GoTouchGra55/CASSINI/Assets/Daraz1.jpg

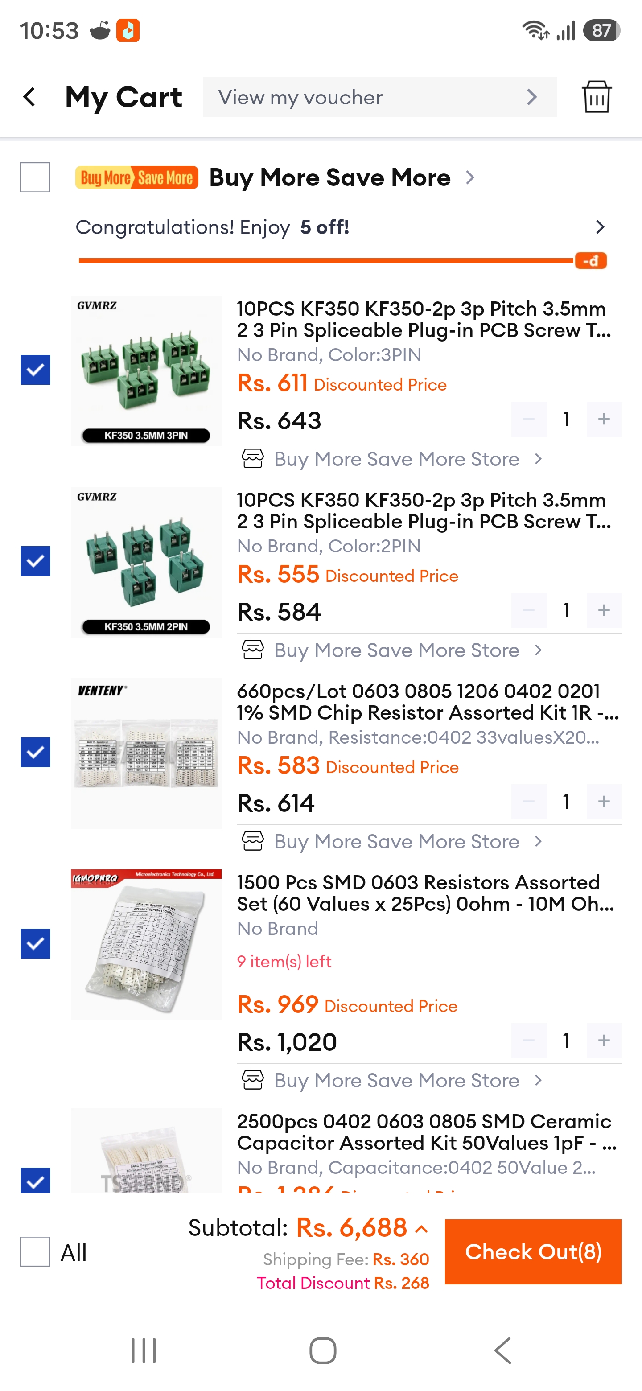
Assets/Daraz1.jpg
