GoTouchGra55/CASSINI/Assets/Daraz2.jpg

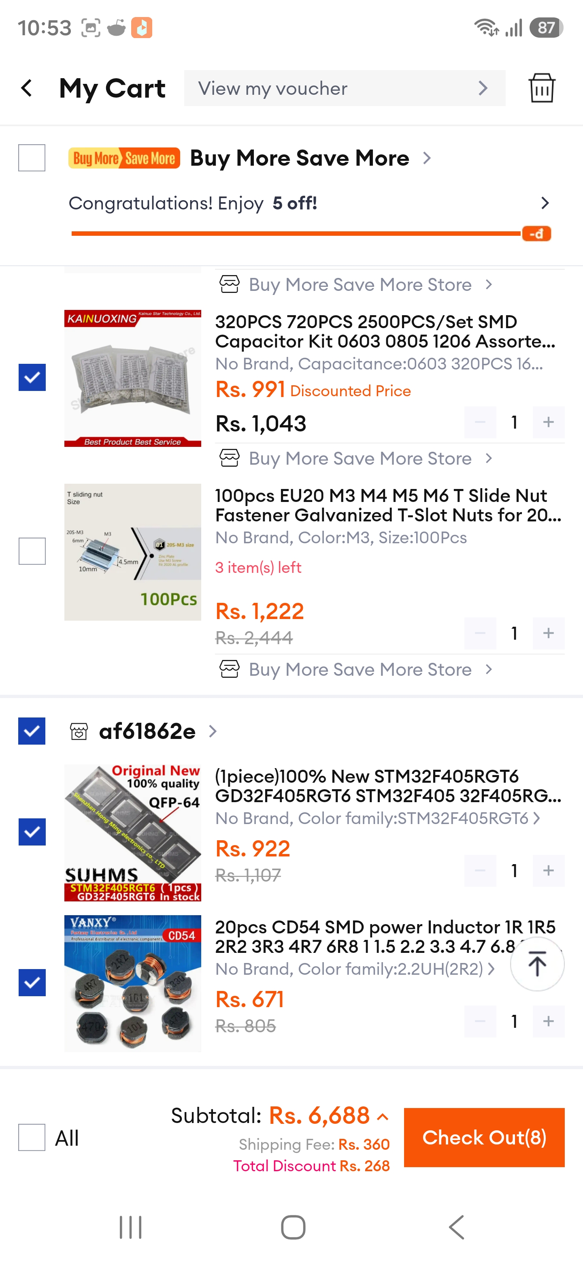
Assets/Daraz2.jpg
