GoTouchGra55/CASSINI/Assets/Daraz3.jpg

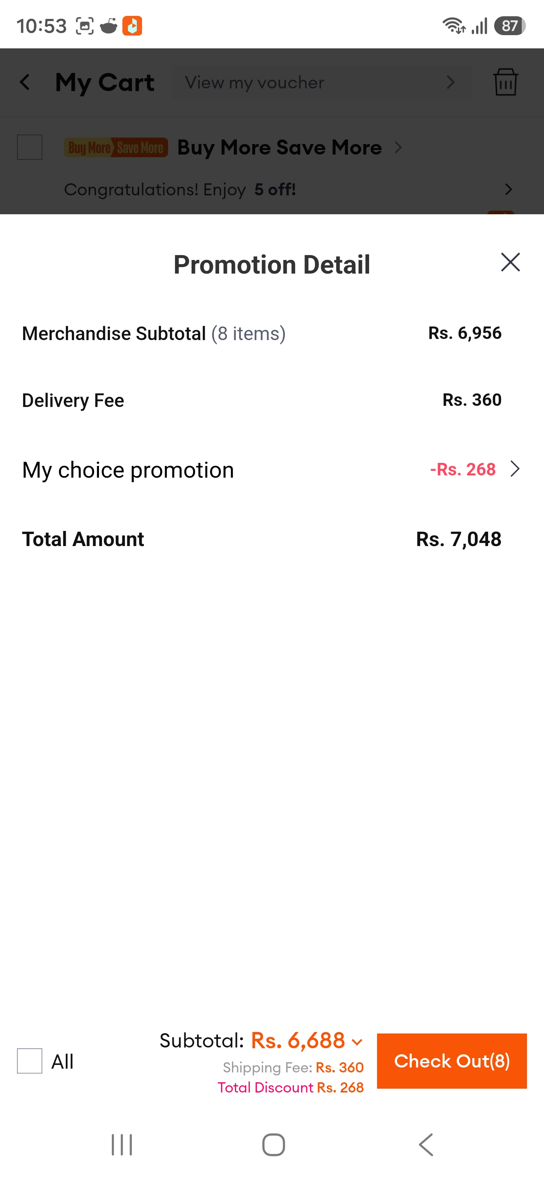
Assets/Daraz3.jpg
