GoTouchGra55/CASSINI/Assets/JLC.png

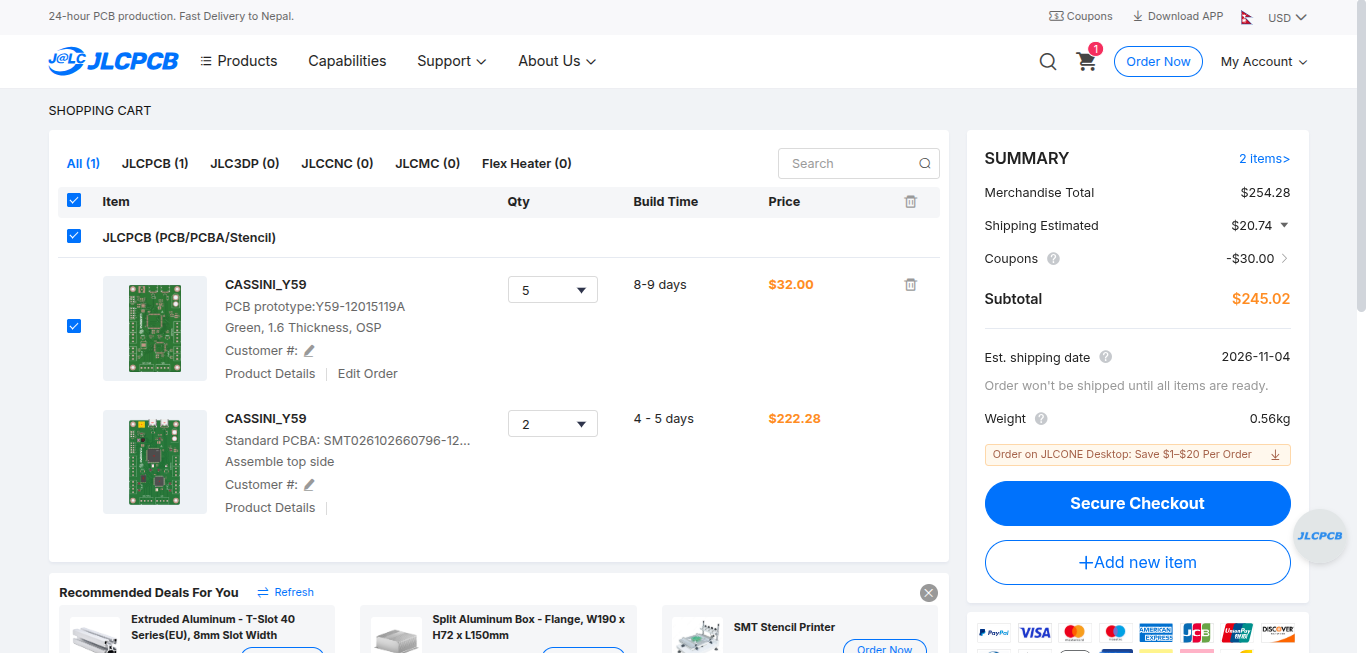
Assets/JLC.png
