GoTouchGra55/CASSINI/BOM.csv

# | Component / Item | Specifications | Qty. | Price (USD)
1 | KF350 Terminal Blocks | 3-pin | 3.5 mm pitch | 10 pcs/lot | 1 lot | $4.03
2 | KF350 Terminal Blocks | 2-pin | 3.5 mm pitch | 10 pcs/lot | 1 lot | $3.67
3 | SMD Resistor Assortment | 660 pcs | mixed packages and values | 1 kit | $3.85
4 | SMD Resistor Assortment | 1 | 500 pcs | 0603 | 60 values | 1 kit | $6.40
5 | SMD Ceramic Capacitor Assortment | 2 | 500 pcs | 50 values | mixed packages | 1 kit | ~$9.15
6 | SMD Ceramic Capacitor Assortment | Mixed packages and quantities | 1 kit | $6.54
7 | STM32F405RGT6 Microcontroller | LQFP-64 | 1 pc | $6.09
8 | CD54 SMD Power Inductor Assortment | 20 pcs | assorted inductance values | 1 kit | $4.43
9 | JLCPCB PCB Fabrication & Assembly | PCB manufacturing and assembly order | 1 order | $245.02
 | **Daraz Merchandise Subtotal** |  |  | **$44.16**
 | Daraz Discount |  |  | −$1.77
 | Daraz Shipping |  |  | $2.38
 | **Daraz Total** |  |  | **$46.54**
 | **JLCPCB Total** |  |  | **$245.02**
 | **GRAND TOTAL** |  |  | **$291.56**
