GoTouchGra55/CASSINI/KiCAD/production/bom.csv

Designator | Footprint | Quantity | Value | LCSC Part #
C1, C10, C11, C12, C13, C14, C15, C16, C17, C19, C2, C24, C25, C26, C27, C28, C30, C31, C37, C38, C40, C41, C42, C43, C44, C5, C66, C67 | 0402 | 28 | 100nF
C18, C23, C3, C4, C64, C65 | 0603 | 6 | 10uF
C20, C62, C63, C9 | 0603 | 4 | 2.2uF
C21, C22 | 0603 | 2 | 22uF
C29, C32, C45 | 0603 | 3 | 1uF
C33, C34 | 0402 | 2 | 20pF
C35, C36 | 0402 | 2 | 10pF
C46 | 0402 | 1 | 470nF
C47 | 0402 | 1 | 47nF
C48 | 0402 | 1 | 47pF
C49, C50 | 0402 | 2 | 5.6pF
C51 | 0402 | 1 | 3pF
C52, C59 | 0402 | 2 | 39pF
C53, C54, C56 | 0402 | 3 | 1.8pF
C55 | 0402 | 1 | 2.4pF
C57, C58 | 0402 | 2 | 1nF
C6 | 0402 | 1 | 22pF
C60, C61 | 0402 | 2 | 3.3pF
C7, C8 | 0402 | 2 | 22uF
D1, D2 | D_SOD-123 | 2 | D_Schottky
FB1, FB2 | 0603 | 2 | FerriteBead
INT_INDICATOR1 | 0402 | 1 | Green
J1 | PinHeader_2x03_P2.54mm_Vertical | 1 | Conn_02x03_Counter_Clockwise
J10, J11, J12, J13 | TerminalBlock_Phoenix_MKDS-1-3-3.81_1x03_P3.81mm_Horizontal | 4 | Screw_Terminal_01x03
J14, J15 | TerminalBlock_Phoenix_MKDS-1-4-3.81_1x04_P3.81mm_Horizontal | 2 | Screw_Terminal_01x04
J16 | PinHeader_2x05_P2.54mm_Vertical | 1 | Conn_02x05_Counter_Clockwise
J2 | AMASS_XT60-M_1x02_P7.20mm_Vertical | 1 | Screw_Terminal_01x02
J20, J21 | USB_C_Receptacle_HRO_TYPE-C-31-M-12 | 2 | USB_C_Receptacle_USB2.0_14P
J5 | SMA_Amphenol_132134-10_Vertical | 1 | SMA
J6, J7, J8, J9 | TerminalBlock_Phoenix_MKDS-1-2-3.81_1x02_P3.81mm_Horizontal | 4 | Screw_Terminal_01x02
L1 | L_Cenker_CKCS3015 | 1 | 2.2uH
L2 | L_Cenker_CKCS3015 | 1 | 5.6uH
L3 | L_Cenker_CKCS3015 | 1 | 15uH
L4 | 0402 | 1 | 47nH
L6 | 0402 | 1 | 2.5nH
L7 | 0402 | 1 | 4.7nH
L8 | 0402 | 1 | 15nH
L9 | 0402 | 1 | 9.1nH
Q1, Q2, Q3, Q4 | TRANS_IRLML6344TRPBF | 4 | NMOS
R1 | 0603 | 1 | 11.3K
R10, R11, R16, R30, R31, R9 | 0603 | 6 | 10K
R17, R18 | 0402 | 2 | 100R
R19, R21, R25, R26 | 0402 | 4 | 1R
R2 | 0603 | 1 | 11.8K
R20, R24, R27, R29 | 0402 | 4 | 4.7k
R22 | 0603 | 1 | 100K
R23 | 0603 | 1 | 22.1K
R28 | 0402 | 1 | 120R
R3 | 0603 | 1 | 45.3K
R4 | 0402 | 1 | 4.99K
R5, R6, R7, R8 | 0402 | 4 | 5.1K
SW1, SW2 | SW_Push_SPST_NO_Alps_SKRK | 2 | RESET
U1 | TPS543620RPYR | 1 | TPS543620RPYR
U10 | SON127P600X800X80-9N | 1 | W25Q512JVEIQ
U2 | SOT-23-6 | 1 | LMR51430
U3 | QFN-24-1EP_4x4mm_P0.5mm_EP2.6x2.6mm | 1 | SX1262IMLTRT
U4 | BMP581 | 1 | BMP581
U5, U8 | IC_ICM-45686 | 2 | ICM-45686
U6 | LQFP-100_14x14mm_P0.5mm | 1 | STM32H743VITx
U7 | LQFP-64_10x10mm_P0.5mm | 1 | STM32F405RGTx
U9 | SOT65P215X110-6N | 1 | PE4259
Y1 | Crystal_SMD_3225-4Pin_3.2x2.5mm | 1 | 25MHz
Y2 | Crystal_SMD_3225-4Pin_3.2x2.5mm | 1 | 10MHz
Y3 | Crystal_SMD_3225-4Pin_3.2x2.5mm | 1 | 32MHz
