GoTouchGra55/CASSINI/KiCAD/CASSINI.kicad_pcb

## KiCad design KiCAD/CASSINI.kicad_pcb (2026-10-26)

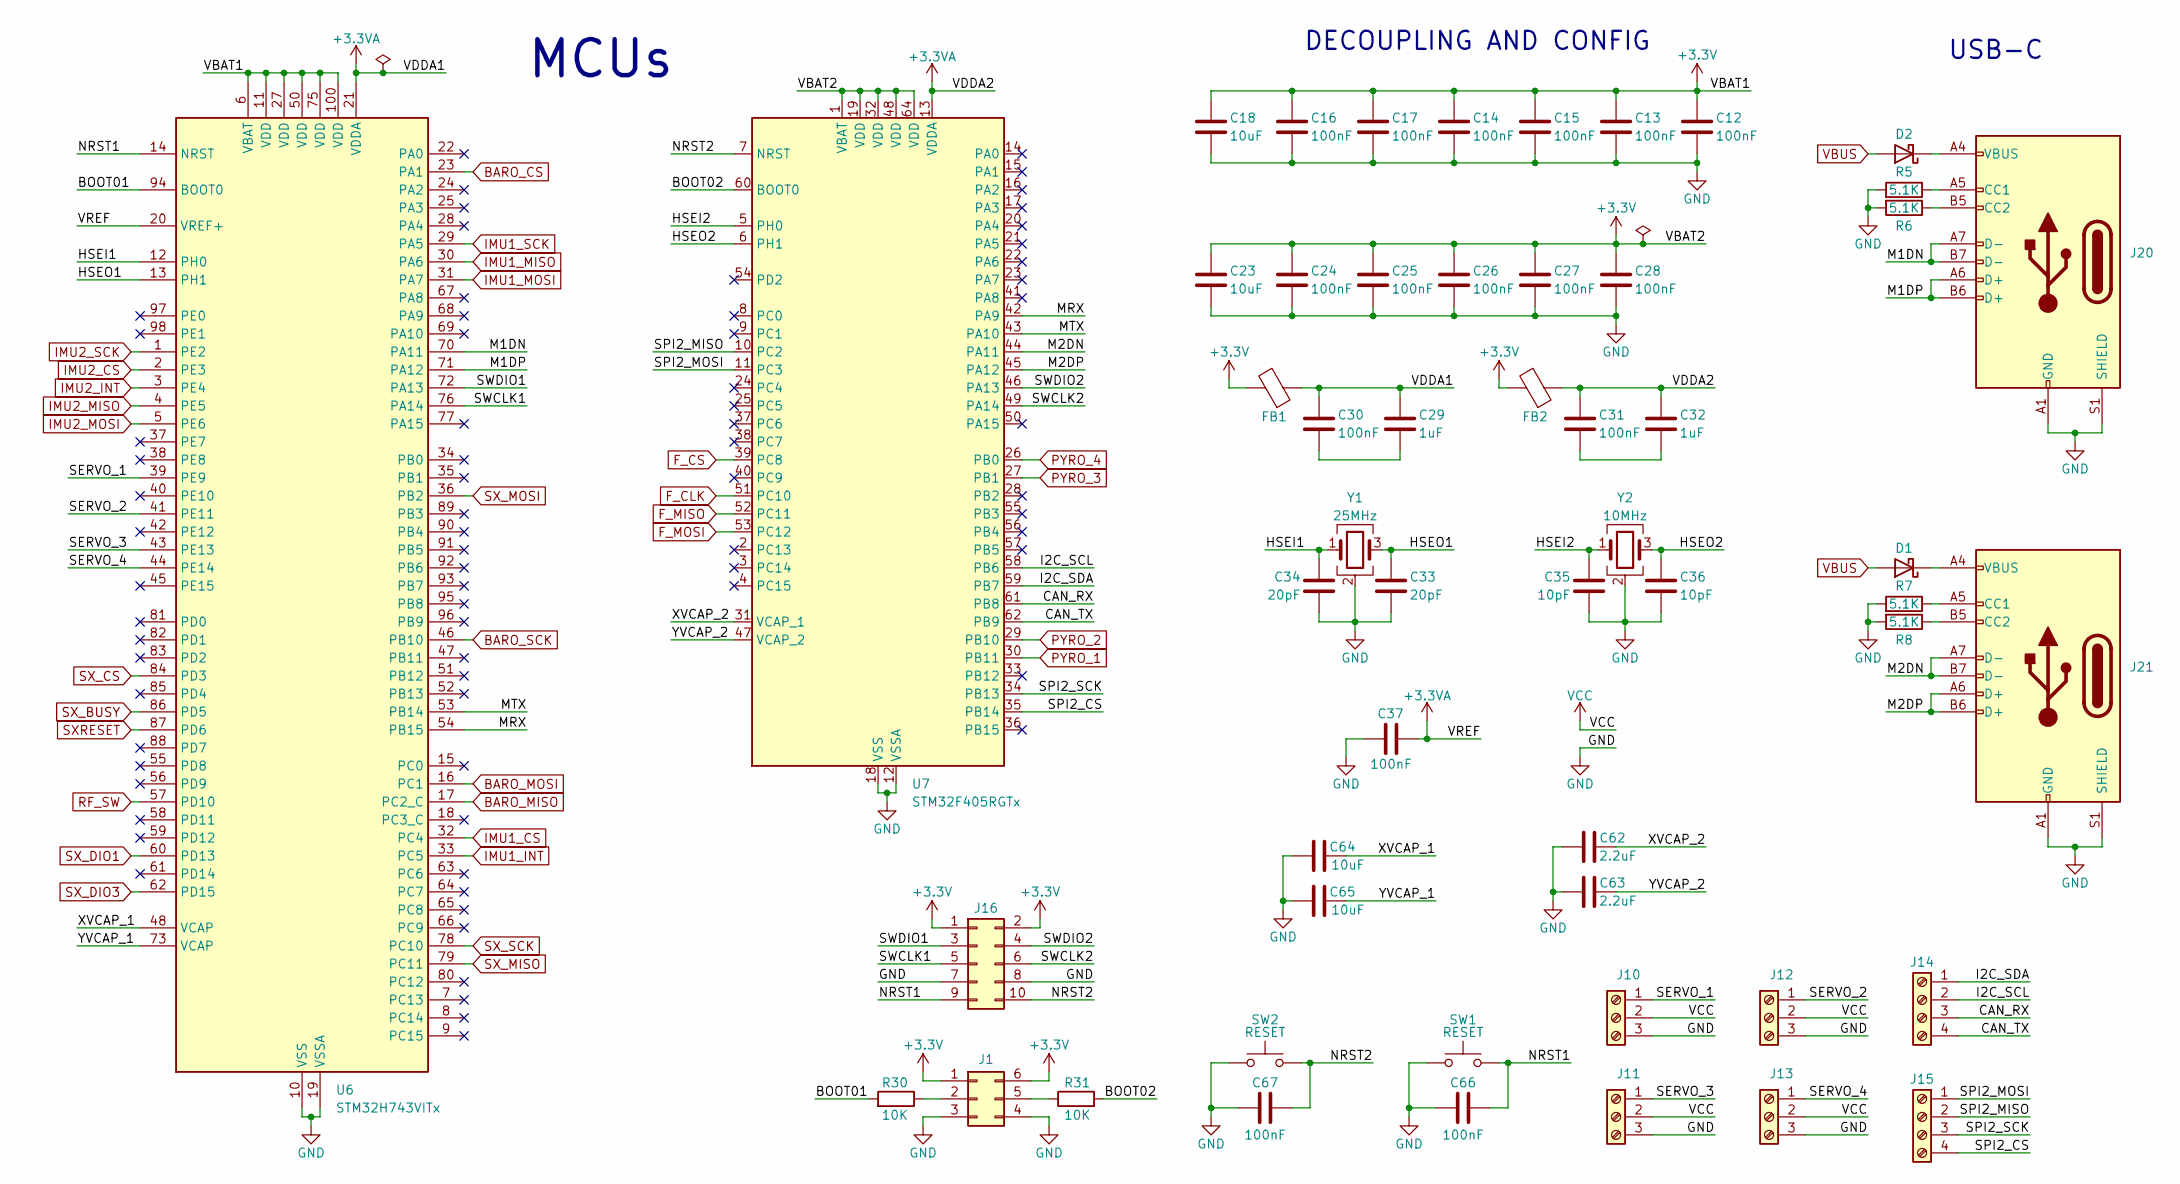
[picture p13: schematic Main.kicad_sch]

Parts:
C12, C13, C14, C15, C16, C17, C24, C25, C26, C27, C28, C30, C31, C37, C66, C67: 100nF; C_0402_1005Metric
C18, C23, C64, C65: 10uF; C_0603_1608Metric
C29, C32: 1uF; C_0603_1608Metric
C33, C34: 20pF; C_0402_1005Metric
C35, C36: 10pF; C_0402_1005Metric
C62, C63: 2.2uF; C_0603_1608Metric
D1, D2: D_Schottky; D_SOD-123
FB1, FB2: FerriteBead; C_0603_1608Metric
J1: Conn_02x03_Counter_Clockwise; PinHeader_2x03_P2.54mm_Vertical
J10, J11, J12, J13: Screw_Terminal_01x03; TerminalBlock_Phoenix_MKDS-1-3-3.81_1x03_P3.81mm_Horizontal
J14, J15: Screw_Terminal_01x04; TerminalBlock_Phoenix_MKDS-1-4-3.81_1x04_P3.81mm_Horizontal
J16: Conn_02x05_Counter_Clockwise; PinHeader_2x05_P2.54mm_Vertical
J20, J21: USB_C_Receptacle_USB2.0_14P; USB_C_Receptacle_HRO_TYPE-C-31-M-12
R5, R6, R7, R8: 5.1K; R_0402_1005Metric
R30, R31: 10K; R_0603_1608Metric
SW1, SW2: RESET; SW_Push_SPST_NO_Alps_SKRK
U6: STM32H743VITx; LQFP-100_14x14mm_P0.5mm
U7: STM32F405RGTx; LQFP-64_10x10mm_P0.5mm
Y1: 25MHz; Crystal_SMD_3225-4Pin_3.2x2.5mm
Y2: 10MHz; Crystal_SMD_3225-4Pin_3.2x2.5mm

Connections:
+3.3V: C12.1, C13.1, C14.1, C15.1, C16.1, C17.1, C18.1, C23.1, C24.1, C25.1, C26.1, C27.1, C28.1, FB1.2, FB2.2, J1.1, J1.6, J16.1, J16.2, U6.6 (VBAT), U6.11 (VDD), U6.27 (VDD), U6.50 (VDD), U6.75 (VDD), U6.100 (VDD), U7.1 (VBAT), U7.19 (VDD), U7.32 (VDD), U7.48 (VDD), U7.64 (VDD); also elsewhere on the board
+3.3VA: C29.1, C30.1, C31.1, C32.1, C37.2, FB1.1, FB2.1, U6.20 (VREF+), U6.21 (VDDA), U7.13 (VDDA)
/Main/BOOT01: R30.2, U6.94 (BOOT0)
/Main/BOOT02: R31.2, U7.60 (BOOT0)
/Main/CAN_RX: J14.3, U7.61 (PB8)
/Main/CAN_TX: J14.4, U7.62 (PB9)
/Main/HSEI1: C34.1, U6.12 (PH0), Y1.1
/Main/HSEI2: C35.1, U7.5 (PH0), Y2.1
/Main/HSEO1: C33.1, U6.13 (PH1), Y1.3
/Main/HSEO2: C36.1, U7.6 (PH1), Y2.3
/Main/I2C_SCL: J14.2, U7.58 (PB6)
/Main/I2C_SDA: J14.1, U7.59 (PB7)
/Main/M1DN: J20.A7 (D-), J20.B7 (D-), U6.70 (PA11)
/Main/M1DP: J20.A6 (D+), J20.B6 (D+), U6.71 (PA12)
/Main/M2DN: J21.A7 (D-), J21.B7 (D-), U7.44 (PA11)
/Main/M2DP: J21.A6 (D+), J21.B6 (D+), U7.45 (PA12)
/Main/MRX: U6.54 (PB15), U7.42 (PA9)
/Main/MTX: U6.53 (PB14), U7.43 (PA10)
/Main/NRST1: C66.2, J16.9, SW1.2, U6.14 (NRST)
/Main/NRST2: C67.2, J16.10, SW2.2, U7.7 (NRST)
/Main/SERVO_1: J10.1, U6.39 (PE9)
/Main/SERVO_2: J12.1, U6.41 (PE11)
/Main/SERVO_3: J11.1, U6.43 (PE13)
/Main/SERVO_4: J13.1, U6.44 (PE14)
/Main/SPI2_CS: J15.4, U7.35 (PB14)
/Main/SPI2_MISO: J15.2, U7.10 (PC2)
/Main/SPI2_MOSI: J15.1, U7.11 (PC3)
/Main/SPI2_SCK: J15.3, U7.34 (PB13)
/Main/SWCLK1: J16.5, U6.76 (PA14)
/Main/SWCLK2: J16.6, U7.49 (PA14)
/Main/SWDIO1: J16.3, U6.72 (PA13)
/Main/SWDIO2: J16.4, U7.46 (PA13)
/Main/XVCAP_1: C64.2, U6.48 (VCAP)
/Main/XVCAP_2: C62.2, U7.31 (VCAP_1)
/Main/YVCAP_1: C65.2, U6.73 (VCAP)
/Main/YVCAP_2: C63.2, U7.47 (VCAP_2)
BARO_CS: U6.23 (PA1); also elsewhere on the board
BARO_MISO: U6.17 (PC2_C); also elsewhere on the board
BARO_MOSI: U6.16 (PC1); also elsewhere on the board
BARO_SCK: U6.46 (PB10); also elsewhere on the board
F_CLK: U7.51 (PC10); also elsewhere on the board
F_CS: U7.39 (PC8); also elsewhere on the board
F_MISO: U7.52 (PC11); also elsewhere on the board
F_MOSI: U7.53 (PC12); also elsewhere on the board
GND: C12.2, C13.2, C14.2, C15.2, C16.2, C17.2, C18.2, C23.2, C24.2, C25.2, C26.2, C27.2, C28.2, C33.2, C34.2, C35.2, C36.2, C37.1, C62.1, C63.1, C64.1, C65.1, C66.1, C67.1, J1.3, J1.4, J10.3, J11.3, J12.3, J13.3, J16.7, J16.8, J20.A1 (GND), J20.A12 (GND), J20.B1 (GND), J20.B12 (GND), J20.S1 (SHIELD), J21.A1 (GND), J21.A12 (GND), J21.B1 (GND), J21.B12 (GND), J21.S1 (SHIELD), R5.2, R6.2, R7.2, R8.2, SW1.1, SW2.1, U6.10 (VSS), U6.19 (VSSA), U6.26 (VSS), U6.49 (VSS), U6.74 (VSS), U6.99 (VSS), U7.12 (VSSA), U7.18 (VSS), U7.63 (VSS), Y1.2 (G), Y1.4 (G), Y2.2 (G), Y2.4 (G); also elsewhere on the board
IMU1_CS: U6.32 (PC4); also elsewhere on the board
IMU1_INT: U6.33 (PC5); also elsewhere on the board
IMU1_MISO: U6.30 (PA6); also elsewhere on the board
IMU1_MOSI: U6.31 (PA7); also elsewhere on the board
IMU1_SCK: U6.29 (PA5); also elsewhere on the board
IMU2_CS: U6.2 (PE3); also elsewhere on the board
IMU2_INT: U6.3 (PE4); also elsewhere on the board
IMU2_MISO: U6.4 (PE5); also elsewhere on the board
IMU2_MOSI: U6.5 (PE6); also elsewhere on the board
IMU2_SCK: U6.1 (PE2); also elsewhere on the board
unnamed: C29.2, C30.2
unnamed: C31.2, C32.2
unnamed: D1.1 (K), J21.A4 (VBUS), J21.A9 (VBUS), J21.B4 (VBUS), J21.B9 (VBUS)
unnamed: D2.1 (K), J20.A4 (VBUS), J20.A9 (VBUS), J20.B4 (VBUS), J20.B9 (VBUS)
unnamed: J1.2, R30.1
unnamed: J1.5, R31.1
unnamed: J20.A5 (CC1), R5.1
unnamed: J20.B5 (CC2), R6.1
unnamed: J21.A5 (CC1), R7.1
unnamed: J21.B5 (CC2), R8.1
PYRO_1: U7.30 (PB11); also elsewhere on the board
PYRO_2: U7.29 (PB10); also elsewhere on the board
PYRO_3: U7.27 (PB1); also elsewhere on the board
PYRO_4: U7.26 (PB0); also elsewhere on the board
RF_SW: U6.57 (PD10); also elsewhere on the board
SXRESET: U6.87 (PD6); also elsewhere on the board
SX_BUSY: U6.86 (PD5); also elsewhere on the board
SX_CS: U6.84 (PD3); also elsewhere on the board
SX_DIO1: U6.60 (PD13); also elsewhere on the board
SX_DIO3: U6.62 (PD15); also elsewhere on the board
SX_MISO: U6.79 (PC11); also elsewhere on the board
SX_MOSI: U6.36 (PB2); also elsewhere on the board
SX_SCK: U6.78 (PC10); also elsewhere on the board
VBUS: D1.2 (A), D2.2 (A); also elsewhere on the board
VCC: J10.2, J11.2, J12.2, J13.2; also elsewhere on the board

Notes on the sheet:
USB-C
MCUs
DECOUPLING AND CONFIG

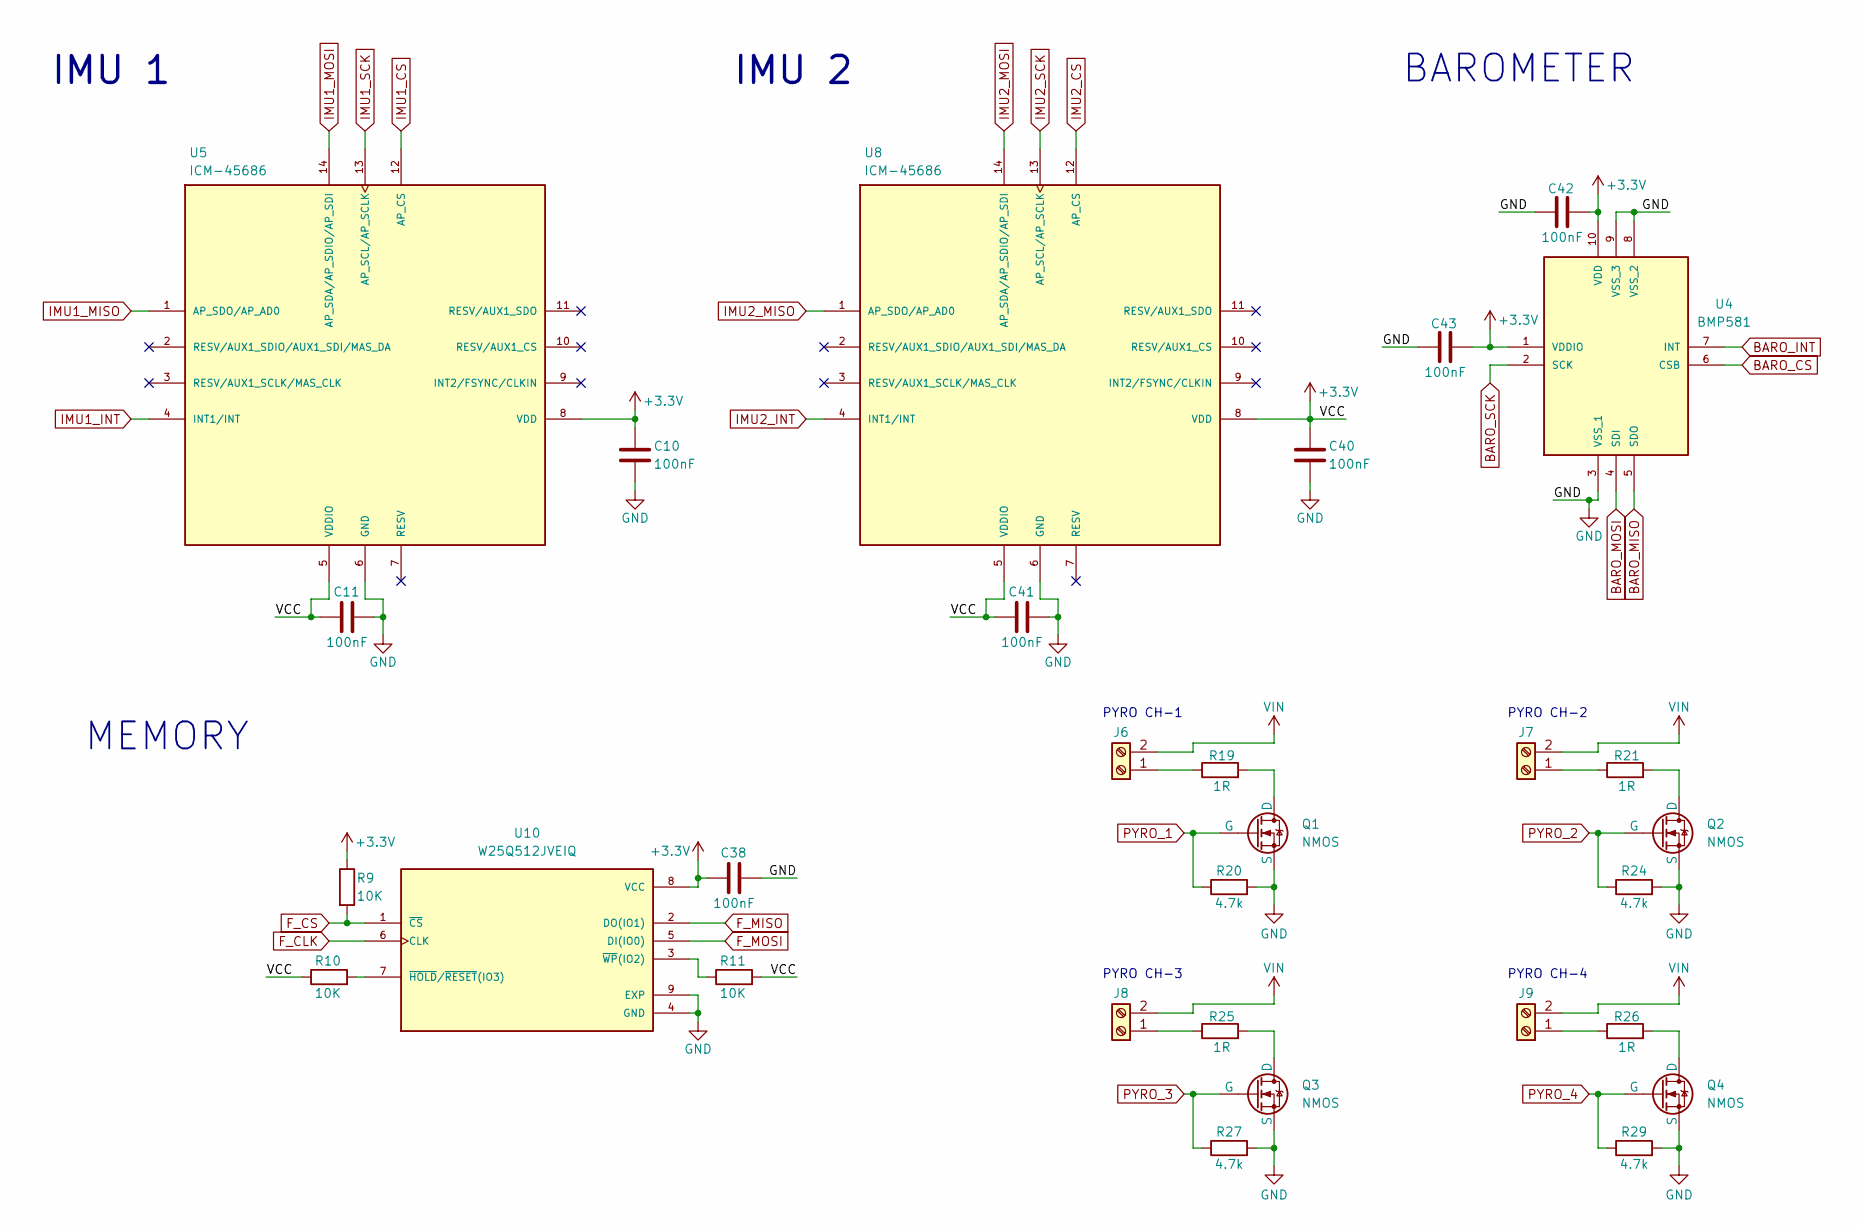
[picture p14: schematic Auxiliary.kicad_sch]

Parts:
C10, C11, C38, C40, C41, C42, C43: 100nF; C_0402_1005Metric
J6, J7, J8, J9: Screw_Terminal_01x02; TerminalBlock_Phoenix_MKDS-1-2-3.81_1x02_P3.81mm_Horizontal
Q1, Q2, Q3, Q4: NMOS; TRANS_IRLML6344TRPBF
R9, R10, R11: 10K; R_0603_1608Metric
R19, R21, R25, R26: 1R; R_0402_1005Metric
R20, R24, R27, R29: 4.7k; R_0402_1005Metric
U4: BMP581; Manufacturer_Part_Number BMP581
U5, U8: ICM-45686; IC_ICM-45686; PARTREV 0.2
U10: W25Q512JVEIQ; SON127P600X800X80-9N; PARTREV G

Connections:
+3.3V: C10.1, C11.2, C38.2, C40.1, C41.2, C42.2, C43.2, R9.1, R10.1, R11.2, U4.1 (VDDIO), U4.10 (VDD), U5.5 (VDDIO), U5.8 (VDD), U8.5 (VDDIO), U8.8 (VDD), U10.8 (VCC); also elsewhere on the board
BARO_CS: U4.6 (CSB); also elsewhere on the board
BARO_INT: U4.7 (INT)
BARO_MISO: U4.5 (SDO); also elsewhere on the board
BARO_MOSI: U4.4 (SDI); also elsewhere on the board
BARO_SCK: U4.2 (SCK); also elsewhere on the board
F_CLK: U10.6 (CLK); also elsewhere on the board
F_CS: R9.2, U10.1 (~CS); also elsewhere on the board
F_MISO: U10.2 (DO(IO1)); also elsewhere on the board
F_MOSI: U10.5 (DI(IO0)); also elsewhere on the board
GND: C10.2, C11.1, C38.1, C40.2, C41.1, C42.1, C43.1, Q1.3 (S), Q2.3 (S), Q3.3 (S), Q4.3 (S), R20.2, R24.2, R27.2, R29.2, U4.3 (VSS_1), U4.8 (VSS_2), U4.9 (VSS_3), U5.6 (GND), U8.6 (GND), U10.4 (GND), U10.9 (EXP); also elsewhere on the board
IMU1_CS: U5.12 (AP_CS); also elsewhere on the board
IMU1_INT: U5.4 (INT1/INT); also elsewhere on the board
IMU1_MISO: U5.1 (AP_SDO/AP_AD0); also elsewhere on the board
IMU1_MOSI: U5.14 (AP_SDA/AP_SDIO/AP_SDI); also elsewhere on the board
IMU1_SCK: U5.13 (AP_SCL/AP_SCLK); also elsewhere on the board
IMU2_CS: U8.12 (AP_CS); also elsewhere on the board
IMU2_INT: U8.4 (INT1/INT); also elsewhere on the board
IMU2_MISO: U8.1 (AP_SDO/AP_AD0); also elsewhere on the board
IMU2_MOSI: U8.14 (AP_SDA/AP_SDIO/AP_SDI); also elsewhere on the board
IMU2_SCK: U8.13 (AP_SCL/AP_SCLK); also elsewhere on the board
unnamed: J6.1, R19.1
unnamed: J7.1, R21.1
unnamed: J8.1, R25.1
unnamed: J9.1, R26.1
unnamed: Q1.1 (D), R19.2
unnamed: Q2.1 (D), R21.2
unnamed: Q3.1 (D), R25.2
unnamed: Q4.1 (D), R26.2
unnamed: R10.2, U10.7 (~HOLD/~RESET(IO3))
unnamed: R11.1, U10.3 (~WP(IO2))
PYRO_1: Q1.2 (G), R20.1; also elsewhere on the board
PYRO_2: Q2.2 (G), R24.1; also elsewhere on the board
PYRO_3: Q3.2 (G), R27.1; also elsewhere on the board
PYRO_4: Q4.2 (G), R29.1; also elsewhere on the board
VBUS: J6.2, J7.2, J8.2, J9.2; also elsewhere on the board

Notes on the sheet:
IMU 1
IMU 2
MEMORY
PYRO CH-3
PYRO CH-2
PYRO CH-4
PYRO CH-1
BAROMETER

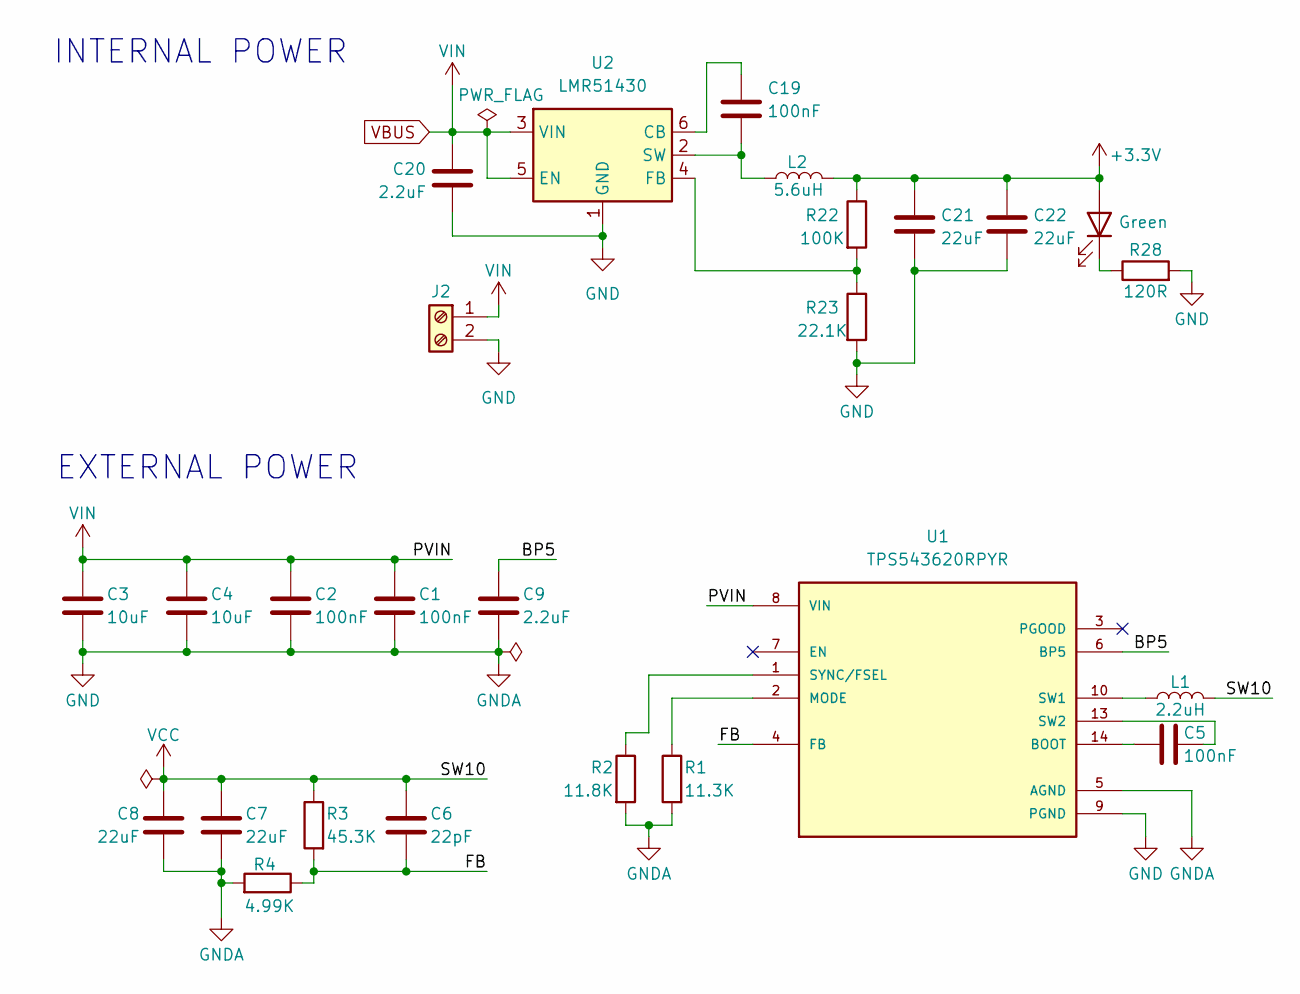
[picture p15: schematic Power.kicad_sch]

Parts:
C1, C2, C5, C19: 100nF; C_0402_1005Metric
C3, C4: 10uF; C_0603_1608Metric
C6: 22pF; C_0402_1005Metric
C7, C8: 22uF; C_0402_1005Metric
C9, C20: 2.2uF; C_0603_1608Metric
C21, C22: 22uF; C_0603_1608Metric
Int_Indicator1: Green; LED_0402_1005Metric
J2: Screw_Terminal_01x02; AMASS_XT60-M_1x02_P7.20mm_Vertical
L1: 2.2uH; L_Cenker_CKCS3015
L2: 5.6uH; L_Cenker_CKCS3015
R1: 11.3K; R_0603_1608Metric
R2: 11.8K; R_0603_1608Metric
R3: 45.3K; R_0603_1608Metric
R4: 4.99K; R_0402_1005Metric
R22: 100K; R_0603_1608Metric
R23: 22.1K; R_0603_1608Metric
R28: 120R; R_0402_1005Metric
U1: TPS543620RPYR; PARTREV A
U2: LMR51430; SOT-23-6

Connections:
+3.3V: C21.1, C22.1, Int_Indicator1.2 (A), L2.1, R22.1; also elsewhere on the board
/Power/BP5: C9.1, U1.6 (BP5)
/Power/FB: C6.2, R3.2, R4.1, U1.4 (FB)
GND: C1.2, C2.2, C3.2, C4.2, C7.2, C8.2, C9.2, C20.2, C21.2, C22.2, J2.2, R1.2, R2.2, R4.2, R23.2, R28.2, U1.5 (AGND), U1.9 (PGND), U1.11 (PGND), U2.1 (GND); also elsewhere on the board
unnamed: Int_Indicator1.1 (K), R28.1
unnamed: C5.1, U1.14 (BOOT)
unnamed: R1.1, U1.2 (MODE)
unnamed: L1.1, U1.10 (SW1)
unnamed: C5.2, U1.13 (SW2)
unnamed: R2.1, U1.1 (SYNC/FSEL)
unnamed: C19.1, U2.6 (CB)
unnamed: R22.2, R23.1, U2.4 (FB)
unnamed: C19.2, L2.2, U2.2 (SW)
VBUS: C1.1, C2.1, C3.1, C4.1, C20.1, J2.1, U1.8 (VIN), U1.12 (VIN), U2.3 (VIN), U2.5 (EN); also elsewhere on the board
VCC: C6.1, C7.1, C8.1, L1.2, R3.1; also elsewhere on the board

Notes on the sheet:
INTERNAL POWER
EXTERNAL POWER

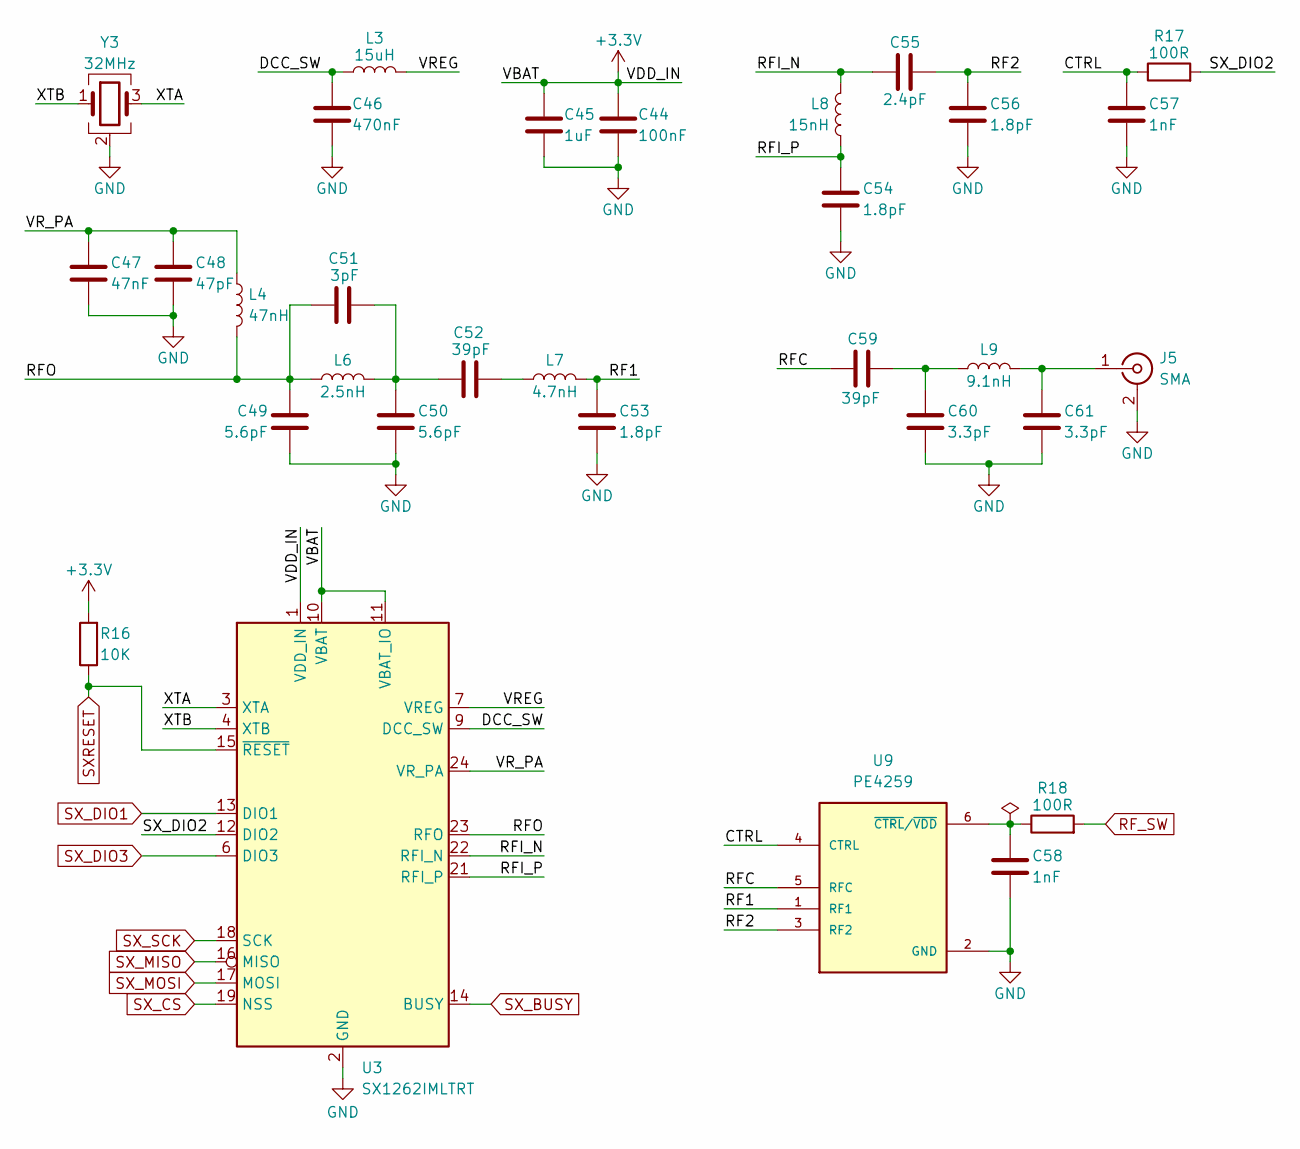
[picture p16: schematic RF.kicad_sch]

Parts:
C44: 100nF; C_0402_1005Metric
C45: 1uF; C_0603_1608Metric
C46: 470nF; C_0402_1005Metric
C47: 47nF; C_0402_1005Metric
C48: 47pF; C_0402_1005Metric
C49, C50: 5.6pF; C_0402_1005Metric
C51: 3pF; C_0402_1005Metric
C52, C59: 39pF; C_0402_1005Metric
C53, C54, C56: 1.8pF; C_0402_1005Metric
C55: 2.4pF; C_0402_1005Metric
C57, C58: 1nF; C_0402_1005Metric
C60, C61: 3.3pF; C_0402_1005Metric
J5: SMA; SMA_Amphenol_132134-10_Vertical
L3: 15uH; L_Cenker_CKCS3015
L4: 47nH; L_0402_1005Metric
L6: 2.5nH; L_0402_1005Metric
L7: 4.7nH; L_0402_1005Metric
L8: 15nH; L_0402_1005Metric
L9: 9.1nH; L_0402_1005Metric
R16: 10K; R_0603_1608Metric
R17, R18: 100R; R_0402_1005Metric
U3: SX1262IMLTRT; QFN-24-1EP_4x4mm_P0.5mm_EP2.6x2.6mm
U9: PE4259; SOT65P215X110-6N
Y3: 32MHz; Crystal_SMD_3225-4Pin_3.2x2.5mm

Connections:
+3.3V: C44.1, C45.1, R16.2, U3.1 (VDD_IN), U3.10 (VBAT), U3.11 (VBAT_IO); also elsewhere on the board
/RF/CTRL: C57.1, R17.1, U9.4 (CTRL)
/RF/DCC_SW: C46.1, L3.1, U3.9 (DCC_SW)
/RF/RF1: C53.1, L7.2, U9.1 (RF1)
/RF/RF2: C55.2, C56.1, U9.3 (RF2)
/RF/RFC: C59.1, U9.5 (RFC)
/RF/RFI_N: C55.1, L8.1, U3.22 (RFI_N)
/RF/RFI_P: C54.1, L8.2, U3.21 (RFI_P)
/RF/RFO: C49.1, C51.1, L4.2, L6.1, U3.23 (RFO)
/RF/SX_DIO2: R17.2, U3.12 (DIO2)
/RF/VREG: L3.2, U3.7 (VREG)
/RF/VR_PA: C47.1, C48.1, L4.1, U3.24 (VR_PA)
/RF/XTA: U3.3 (XTA), Y3.3
/RF/XTB: U3.4 (XTB), Y3.1
GND: C44.2, C45.2, C46.2, C47.2, C48.2, C49.2, C50.2, C53.2, C54.2, C56.2, C57.2, C58.2, C60.2, C61.2, J5.2 (Ext), U3.2 (GND), U3.5 (GND), U3.8 (GND), U3.20 (GND), U3.25 (GND), U9.2 (GND), Y3.2 (G), Y3.4 (G); also elsewhere on the board
unnamed: C50.1, C51.2, C52.1, L6.2
unnamed: C52.2, L7.1
unnamed: C59.2, C60.1, L9.1
unnamed: C61.1, J5.1 (In), L9.2
unnamed: C58.1, R18.1, U9.6 (~CTRL/~VDD)
RF_SW: R18.2; also elsewhere on the board
SXRESET: R16.1, U3.15 (~RESET); also elsewhere on the board
SX_BUSY: U3.14 (BUSY); also elsewhere on the board
SX_CS: U3.19 (NSS); also elsewhere on the board
SX_DIO1: U3.13 (DIO1); also elsewhere on the board
SX_DIO3: U3.6 (DIO3); also elsewhere on the board
SX_MISO: U3.16 (MISO); also elsewhere on the board
SX_MOSI: U3.17 (MOSI); also elsewhere on the board
SX_SCK: U3.18 (SCK); also elsewhere on the board

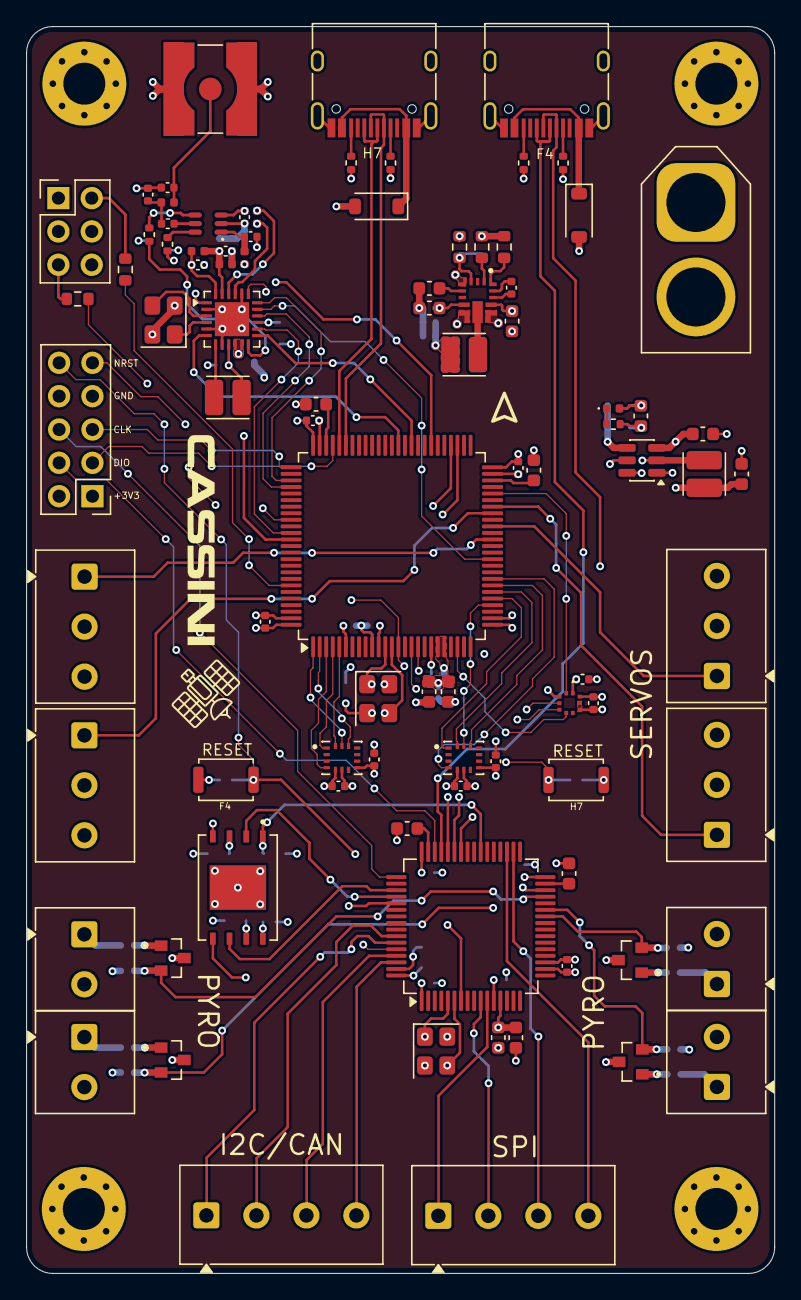
[picture p17: board CASSINI.kicad_pcb from above]

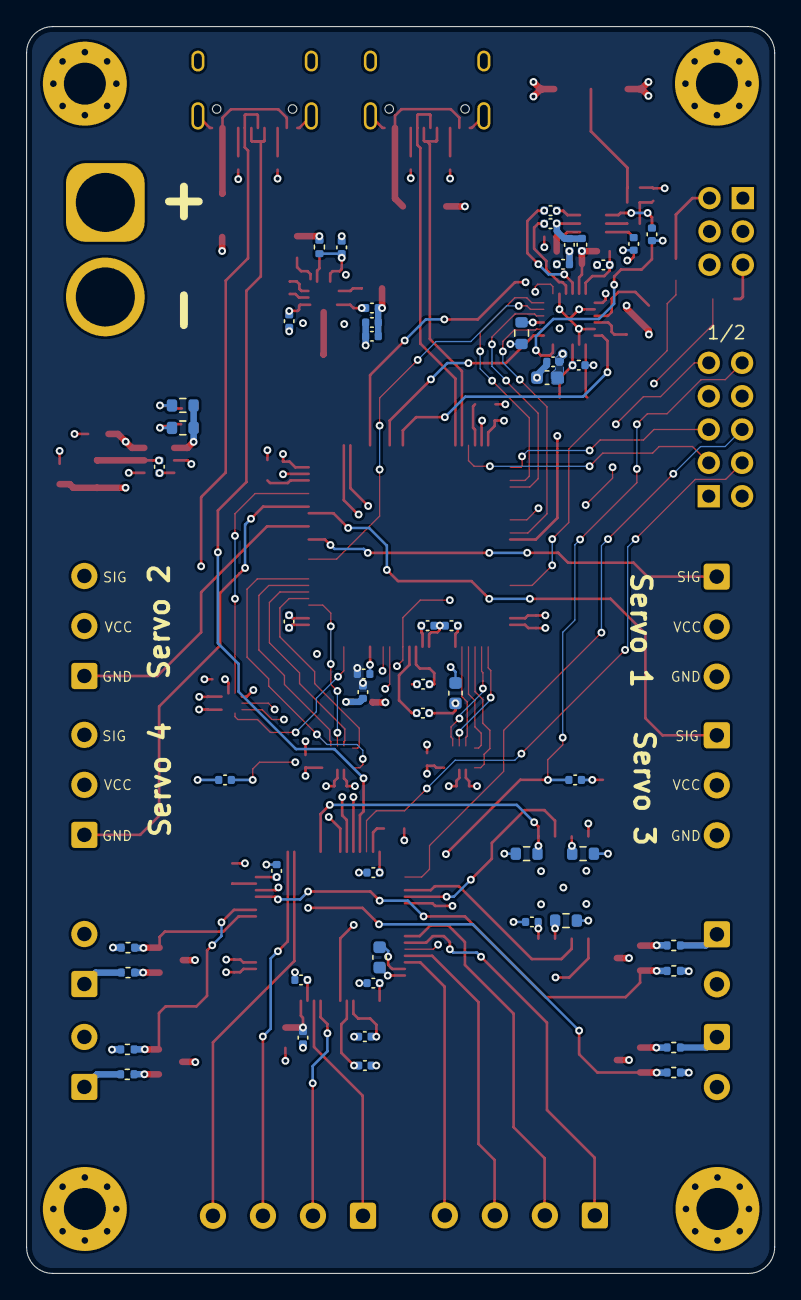
[picture p18: board CASSINI.kicad_pcb from below]

Board: 6 copper layers, 57.0 x 95.0 mm, 142 parts (51 on the bottom side), 119 nets.

Other parts of the board:
ww: LOGO
