GoTouchGra55/CASSINI/CASSINI/CASSINI-H7/CASSINI-H7.ioc

Mcu.UserName=STM32H743VITx
PA1.GPIO_Label=BARO_CS
PA1.Signal=GPIO_Output
PA11.Signal=USB_OTG_FS_DM
PA12.Signal=USB_OTG_FS_DP
PA5.GPIO_Label=IMU1_SCK
PA5.Signal=SPI1_SCK
PA6.GPIO_Label=IMU1_MISO
PA6.Signal=SPI1_MISO
PA7.GPIO_Label=IMU1_MOSI
PA7.Signal=SPI1_MOSI
PB10.GPIO_Label=BARO_SCK
PB10.Signal=SPI2_SCK
PB14.Signal=USART1_TX
PB15.Signal=USART1_RX
PB2.GPIO_Label=SX_MOSI
PB2.Signal=SPI3_MOSI
PC1.GPIO_Label=BARO_MOSI
PC1.Signal=SPI2_MOSI
PC10.GPIO_Label=SX_SCK
PC10.Signal=SPI3_SCK
PC11.GPIO_Label=SX_MISO
PC11.Signal=SPI3_MISO
PC2_C.GPIO_Label=BARO_MISO
PC2_C.Signal=SPI2_MISO
PC4.GPIO_Label=IMU1_CS
PC4.Signal=GPIO_Output
PD10.GPIO_Label=RF_SW
PD10.Signal=GPIO_Output
PD13.GPIO_Label=SX_DIO1
PD13.Signal=GPXTI13
PD15.GPIO_Label=SX_DIO3
PD15.Signal=GPXTI15
PD3.GPIO_Label=SX_CS
PD3.Signal=GPIO_Output
PD5.GPIO_Label=SX_BUSY
PD5.Signal=GPIO_Input
PD6.GPIO_Label=SXRESET
PD6.Signal=GPIO_Output
PE11.GPIO_Label=SERVO_2
PE11.Signal=S_TIM1_CH2
PE13.GPIO_Label=SERVO_3
PE13.Signal=S_TIM1_CH3
PE14.GPIO_Label=SERVO_4
PE14.Signal=S_TIM1_CH4
PE2.GPIO_Label=IMU2_SCK
PE2.Signal=SPI4_SCK
PE3.GPIO_Label=IMU2_CS
PE3.Signal=GPIO_Output
PE5.GPIO_Label=IMU2_MISO
PE5.Signal=SPI4_MISO
PE6.GPIO_Label=IMU2_MOSI
PE6.Signal=SPI4_MOSI
PE9.GPIO_Label=SERVO_1
PE9.Signal=S_TIM1_CH1
